vova-tymosh/SherlineDRO/schematic/SherlineDRO Schematic.png

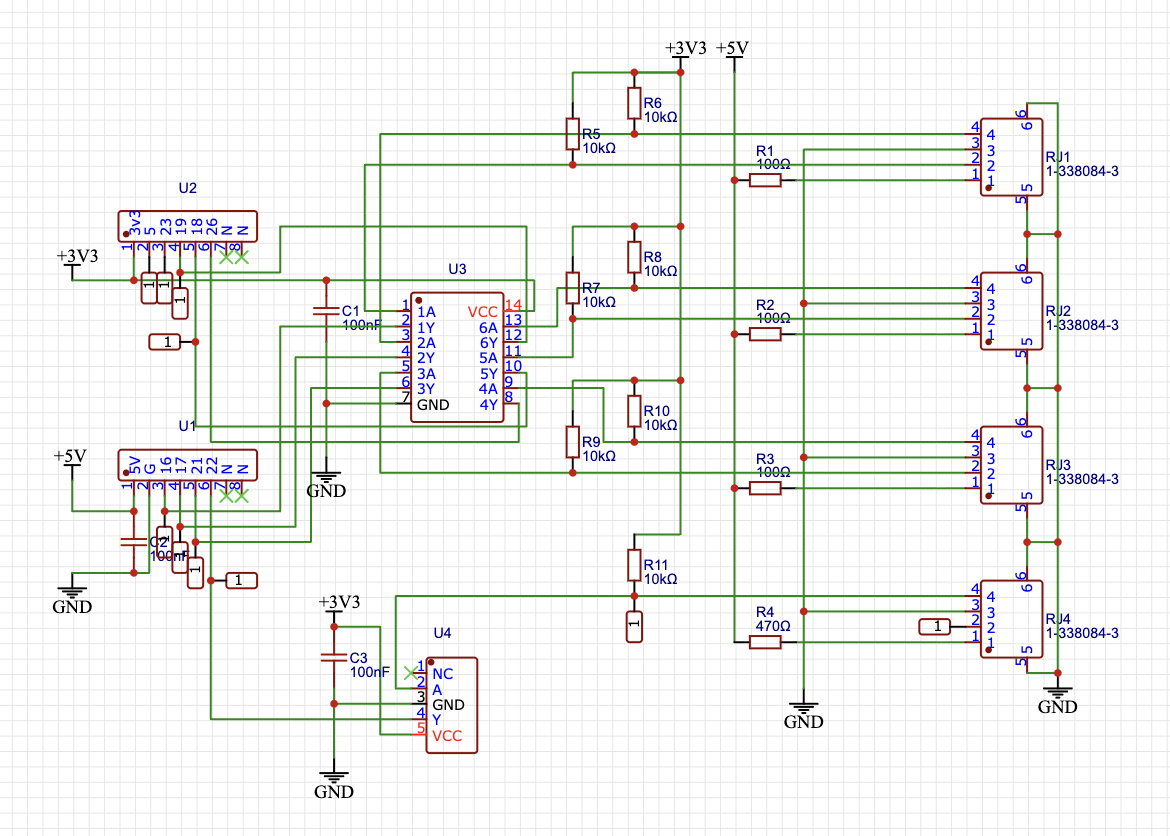
schematic/SherlineDRO Schematic.png
