vova-tymosh/SherlineDRO/fabrication/BOM_SherlineSensors.csv

ID | Name | Designator | Footprint | Quantity | Manufacturer Part | Manufacturer | Supplier | Supplier Part | Price
1 | 10kΩ | R5,R6,R7,R8,R9,R10,R11 | R0402 | 7 | 0402WGF1002TCE | UNI-ROYAL(厚声) | LCSC | C25744 | 0.002
2 | 100nF | C1,C2,C3 | C0402 | 3 | CL05B104KO5NNNC | SAMSUNG(三星) | LCSC | C1525 | 0.005
3 | 100Ω | R1,R2,R3 | R0603 | 3 | 0603WAF1000T5E | UNI-ROYAL(厚声) | LCSC | C22775 | 0.011
4 | PM2.54-1X8PM-H85 | U1,U2 | HDR-TH_8P-P2.54-V-F | 2 | PM2.54-1X8PM-H85 | JXTCONN(聚兴泰) | LCSC | C42431840 | 0.112
5 | MC74HC14ADTR2G | U3 | TSSOP-14_L5.0-W4.4-P0.65-LS6.4-BL | 1 | MC74HC14ADTR2G | onsemi(安森美) | LCSC | C152539 | 0.282
6 | SN74LVC1G14DCKR | U4 | SC-70-5_L2.1-W1.3-P0.65-LS2.1-BR | 1 | SN74LVC1G14DCKR | TI(德州仪器) | LCSC | C35740 | 0.065
7 | 1-338084-3 | RJ1,RJ2,RJ3,RJ4 | RJ45-SMD_TE_1-338084-3 | 4 | 1-338084-3 | TE Connectivity(泰科电子) | LCSC | C590940 | 2.179
8 | 470Ω | R4 | R0603 | 1 | 0603WAF4700T5E | UNI-ROYAL(厚声) | LCSC | C23179 | 0.003
