vova-tymosh/SherlineDRO/(commit log)

2026-07-29 Add backlash back
2026-07-29 Refactor encoder logic into class and add Y axis support
    - Created EncoderAxis class to encapsulate encoder state and backlash logic
    - Moved processPulse() logic into class method for cleaner ISR code
    - Added Y axis support on pins 21 (A) and 26 (B)
    - All three axes (X, Y, Z) now use same EncoderAxis class
    - Y axis output added to TouchDRO data stream
    [SherlineDRO.ino]
2026-07-29 Move interrupt setup into classes and create TachoSensor class
    - Moved attachInterrupt() into EncoderAxis.begin() method
    - Created TachoSensor class for consistency with encoder design
    - Encapsulated RPM calculation logic in TachoSensor.calculateRPM()
    - Cleaner setup code - all sensors now initialize with .begin(isr)
    - All sensor configuration now in constructors
2026-07-29 Add fabrication and schematic
    [BOM_SherlineSensors.csv, PickAndPlace_PCB_SherlineSensors.csv]
2026-08-02 Fix backlach, change settings
    [SherlineDRO.ino]
2026-09-20 Some RPM attempts (failed)
    [SherlineDRO.ino]
2026-09-30 Redesign RPM from opto sensor to Servo
    [SherlineDRO.ino, Tacho.h]
2026-10-03 Change the design to PCNT
    - Should be more resilient to BT interupts and other ways of missing pings
    - Counts proper quadrupple sequence with 2x more signal compare to old way
    [SherlineDRO.ino]
2026-10-03 Add axis position debug output and retune backlash constants
    Print the compensated x/y/z counts to Serial on a separate 10Hz timer, independent of the 25Hz TouchDRO stream.
    Retune measured backlash: X 3->6, Z 5->10, and Y 1->0 to disable compensation on that axis.
    [SherlineDRO.ino]
2026-10-03 Fix/improve backlash
    - Fix partial cases, when you turn wheel part of backlash and reverse a direction again
    [SherlineDRO.ino]
